LZ1DPN/Minima3-2017/DDS-0-30MHz/circuitDDS-Arduino-AD-LCD.png

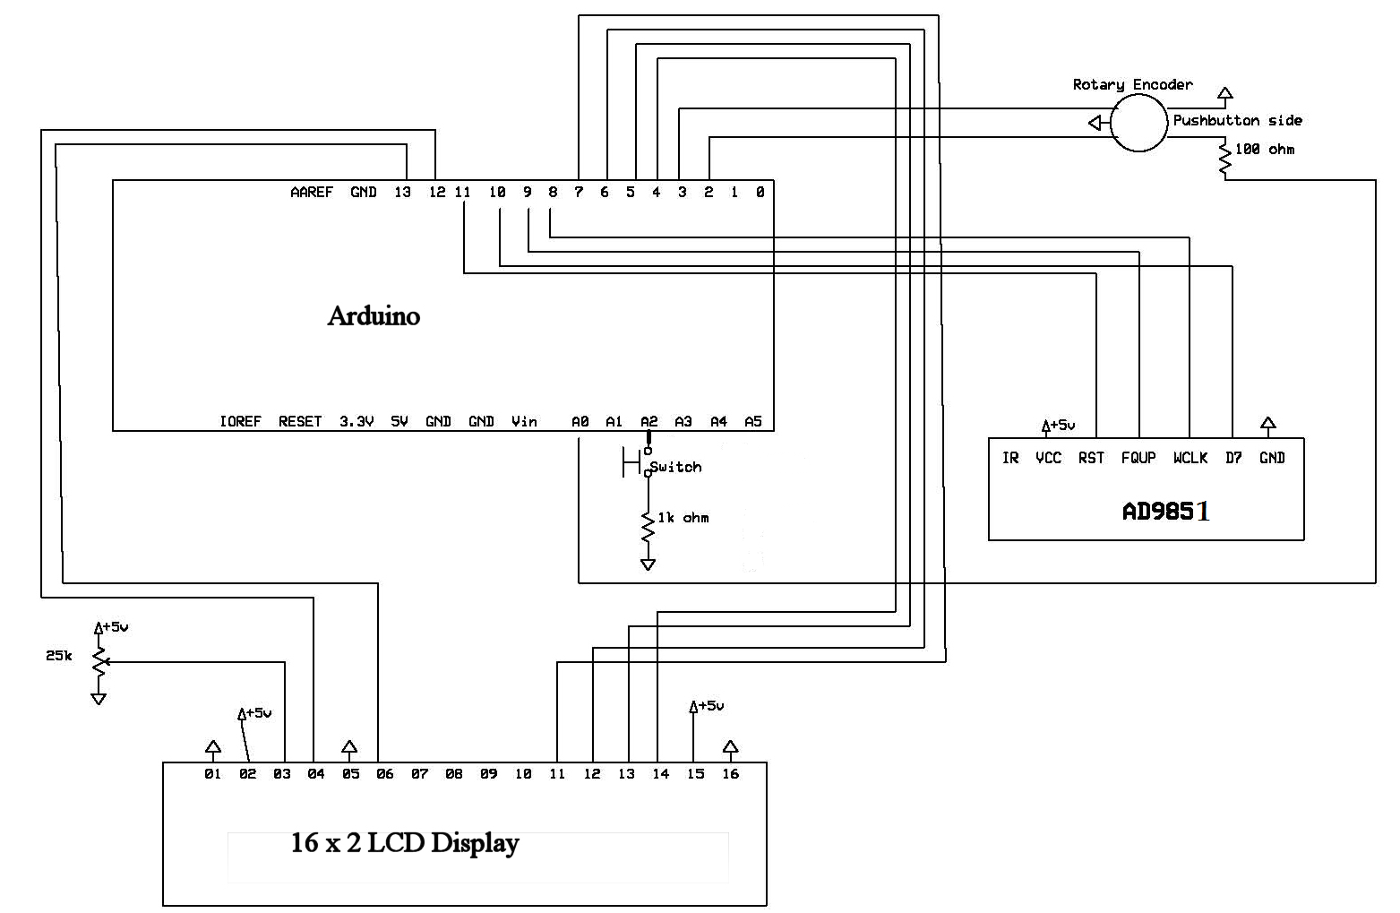
DDS-0-30MHz/circuitDDS-Arduino-AD-LCD.png
