LZ1DPN/Minima3-2017/DDS-0-30MHz/DDSbuffer.png

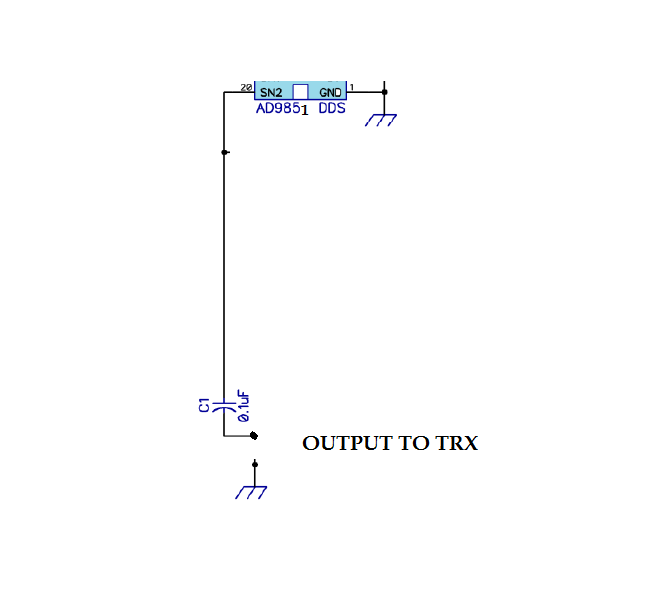
DDS-0-30MHz/DDSbuffer.png
