LZ1DPN/Minima3-2017/DDS-0-30MHz/OLEDtoARDUINOschema.jpg

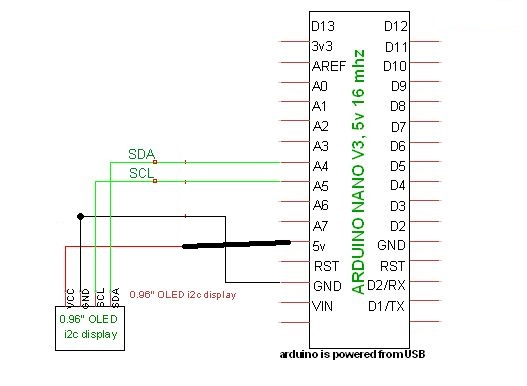
DDS-0-30MHz/OLEDtoARDUINOschema.jpg
