LZ1DPN/Minima3-2017/(commit log)

2017-02-16 16.02.2017
    16.02.2017
    [xtals20mhz-m3.xls]
2017-04-26 26.04.2017
    26.04.2017
    [xtals20mhz-m3.xls]
